v6cl/WinchRack/README.md

WinchRack 
Motor powered standalone spool rewinder for Annex Tradrack

Operates at 5 volt. (Can use 5v pin on control board or external power source)

just 5 voltage, nothing else required.
