v6cl/WinchRack/v0.4/README.md

# WinchRack
Motor powered standalone spool rewinder for Annex Tradrack



Operates at 5 volt. (Can use 5v pin on control board or external power source)

just 5 voltage, nothing else required.

(Example setting)



## Test video

Visit https://www.youtube.com/watch?v=kO5R-0rNxZA

Visit https://www.youtube.com/shorts/trHfZH3sDRs

## BOM

Wago 5pin x 2

Opto endstop x 1 (https://zrr.kr/ZYrV)

n20 gear motor 300 rpm 5v ~ 6v x  1 (https://zrr.kr/aFPa)

ls-p20/15 3kg x 2 (https://zrr.kr/Rqkb)

mosfet switch 1ch x 1 (https://zrr.kr/TrOc)

608zz x 4

623zz x 5

silicon ring x 1 (https://zrr.kr/E5Dk)

PTFE tube 3x4 or 2x4 

m3 insert nut (OD 5mm, L 4mm)

m3 bolts 

m4 bolt 15mm x 2

m2 self tapping screw 8~10mm x 2

6mm collet for 4mm PTFE Tube x 1 (https://zrr.kr/7WdG)

# unresolved problems

- Problem with new filament spools coming loose and tangling

- A state in which the motor rotates infinitely when rewinding after filament is removed from an almost completely used filament spool.
