v6cl/WinchRack/v0.5/STL/Buffer/readme.md

> [!CAUTION]
> For SensorFin, it is recommended to use matte and dark colored filament. Glossy or bright colors produce a weak signal.
