v6cl/WinchRack/v0.6/STL/MotorWheel.stl

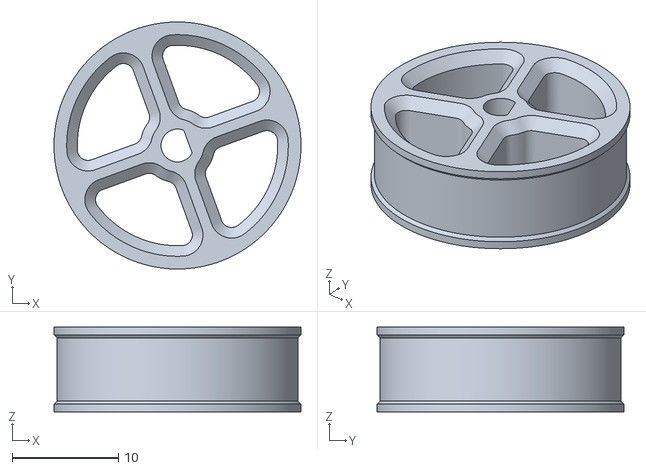
[picture p1: CAD file, 2024-03-28]
v0.6/STL/MotorWheel.stl
23.3 x 23.3 x 8.00
