v6cl/WinchRack/v0.6/STL/HangerExtender.stl

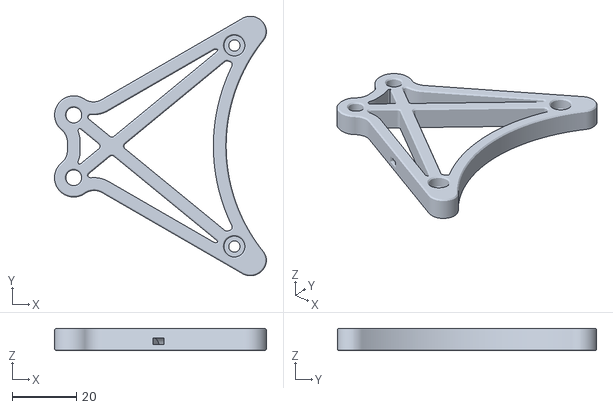
[picture p2: CAD file, 2024-03-28]
v0.6/STL/HangerExtender.stl
66.0 x 80.8 x 7.00
