v6cl/WinchRack/v0.6/STL/SpoolWheel_rev2.stl

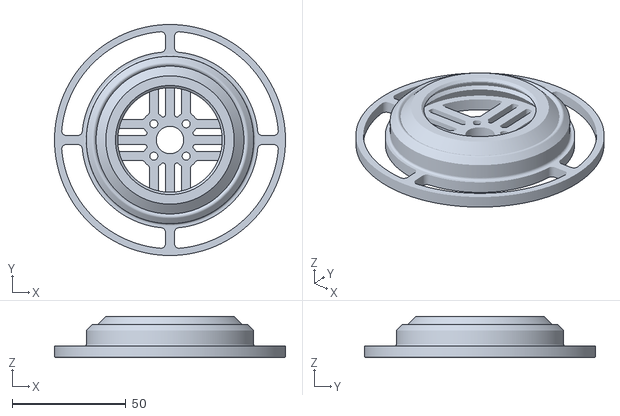
[picture p3: CAD file, 2024-03-28]
v0.6/STL/SpoolWheel_rev2.stl
101.5 x 101.5 x 18.1
