v6cl/WinchRack/v0.6/STL/Wago2411Mount.stl

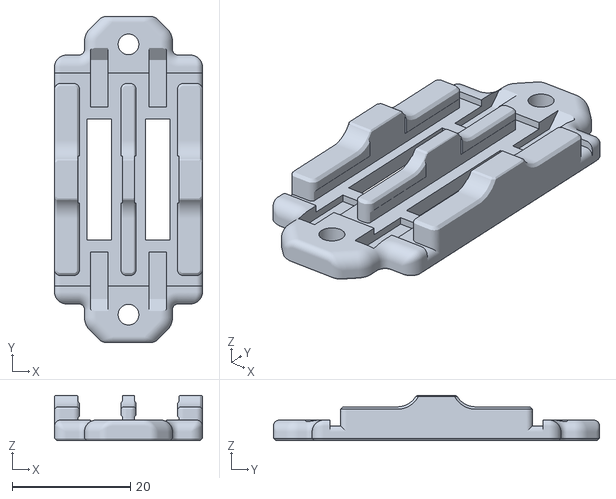
[picture p5: CAD file, 2024-03-28]
v0.6/STL/Wago2411Mount.stl
25.1 x 55.2 x 7.70
