v6cl/WinchRack/v0.6/STL/BufferCore_rev7_b.stl

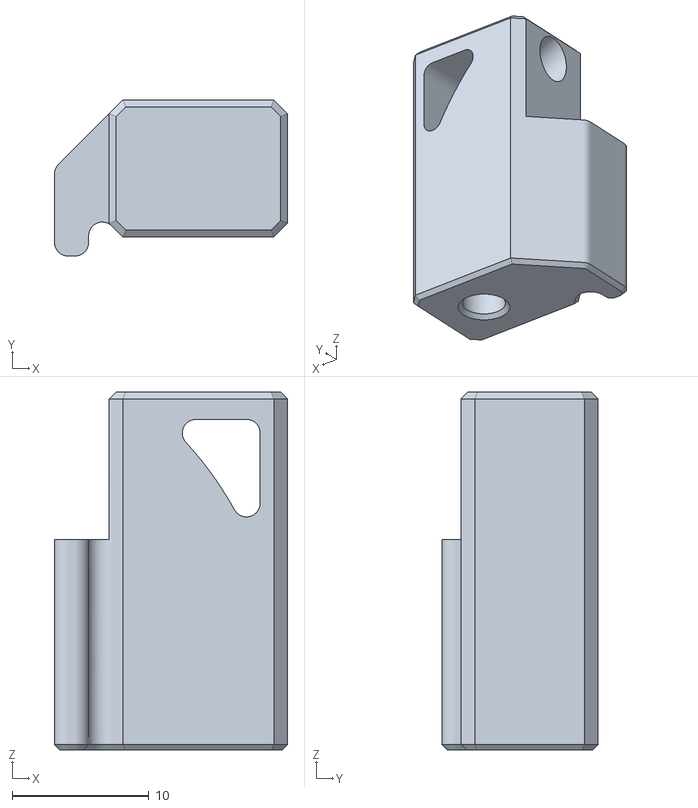
[picture p6: CAD file, 2024-03-28]
v0.6/STL/BufferCore_rev7_b.stl
17.0 x 11.4 x 26.1
