v6cl/WinchRack/v0.6/STL/ProfileFoot.stl

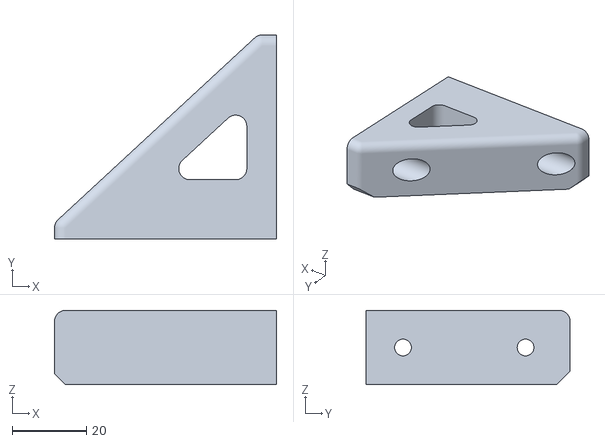
[picture p7: CAD file, 2024-03-28]
v0.6/STL/ProfileFoot.stl
59.8 x 55.0 x 20.0
