v6cl/WinchRack/v0.6/STL/FrontBufferMount_10mmOffset.stl

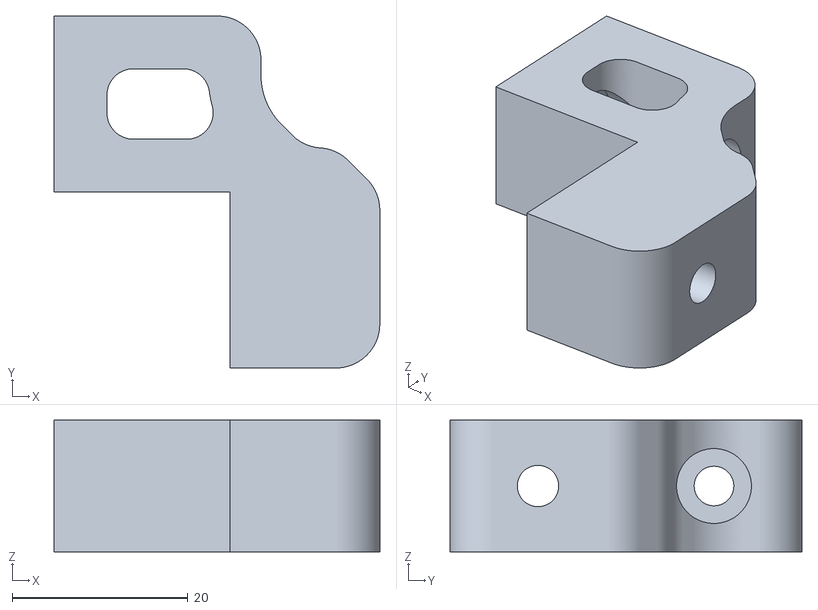
[picture p8: CAD file, 2024-03-28]
v0.6/STL/FrontBufferMount_10mmOffset.stl
37.0 x 40.0 x 15.0
