v6cl/WinchRack/v0.6/STL/RearBufferMount.stl

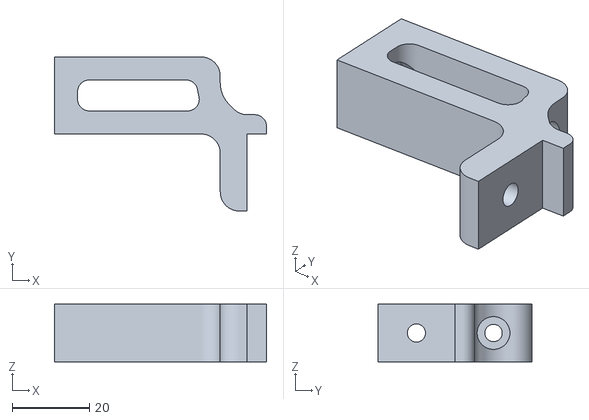
[picture p9: CAD file, 2024-03-28]
v0.6/STL/RearBufferMount.stl
55.0 x 40.0 x 15.0
