v6cl/WinchRack/v0.6/STL/RearBufferMount_10mmOffset.stl

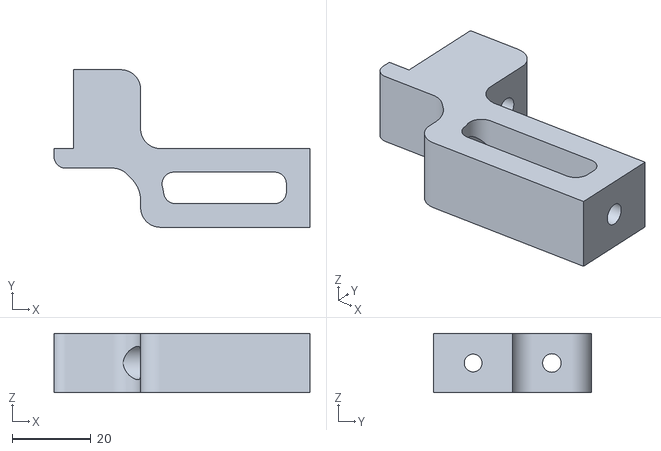
[picture p10: CAD file, 2024-03-28]
v0.6/STL/RearBufferMount_10mmOffset.stl
65.0 x 40.0 x 15.0
