v6cl/WinchRack/v0.6/STL/MotorArm.stl

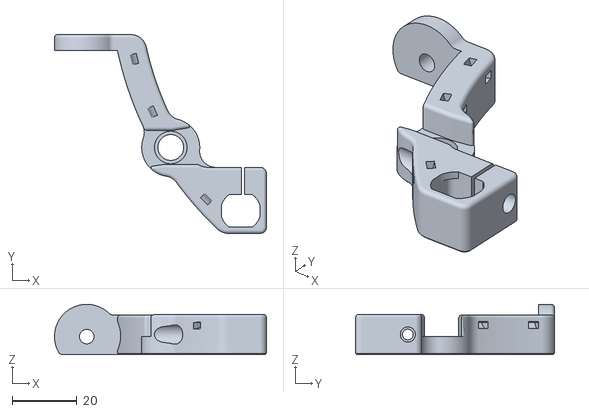
[picture p11: CAD file, 2024-03-28]
v0.6/STL/MotorArm.stl
65.7 x 61.6 x 15.6
