v6cl/WinchRack/v0.6/STL/CornerBrkt.stl

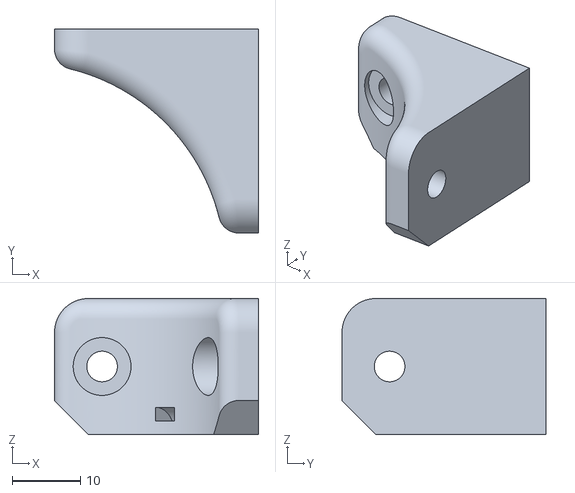
[picture p12: CAD file, 2024-03-28]
v0.6/STL/CornerBrkt.stl
30.0 x 30.0 x 20.0
