v6cl/WinchRack/v0.6/STL/BufferBase_rev4.stl

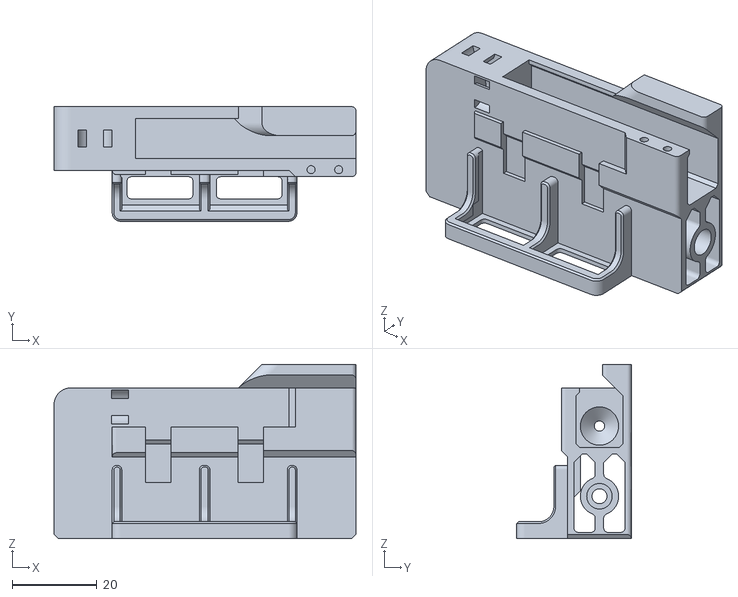
[picture p13: CAD file, 2024-03-27]
v0.6/STL/BufferBase_rev4.stl
71.1 x 27.0 x 41.1
