v6cl/WinchRack/v0.4/STL/Buffer/BufferWheel.stl

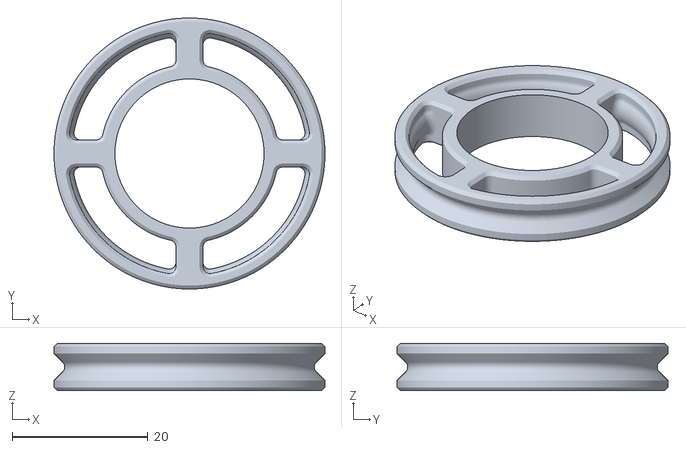
[picture p14: CAD file, 2024-02-13, an earlier design]
v0.4/STL/Buffer/BufferWheel.stl
40.0 x 40.0 x 7.00
