v6cl/WinchRack/v0.4/STL/Spool/SpoolRoller/RollerGripCore.stl

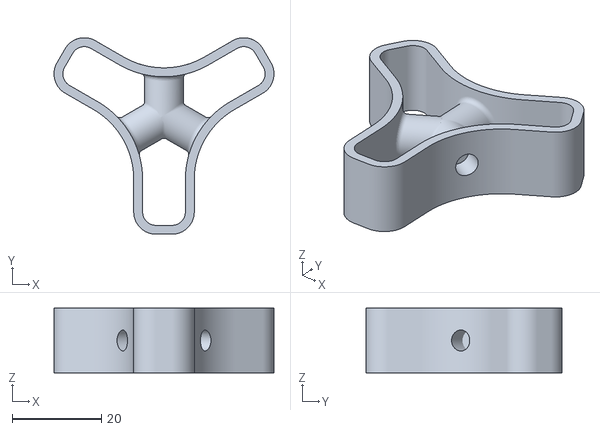
[picture p15: CAD file, 2024-02-13, an earlier design]
v0.4/STL/Spool/SpoolRoller/RollerGripCore.stl
49.4 x 44.1 x 14.5
