v6cl/WinchRack/v0.4/STL/Spool/SpoolStand/StandSidebar.stl

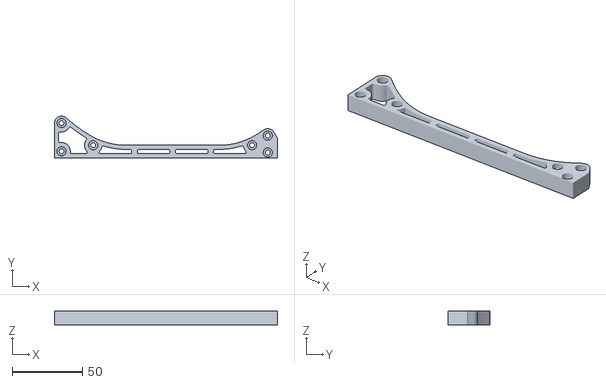
[picture p16: CAD file, 2024-02-13, an earlier design]
v0.4/STL/Spool/SpoolStand/StandSidebar.stl
158.2 x 29.7 x 10.0
