v6cl/WinchRack/v0.5/STL/Buffer/BufferCarrier_rev2.stl

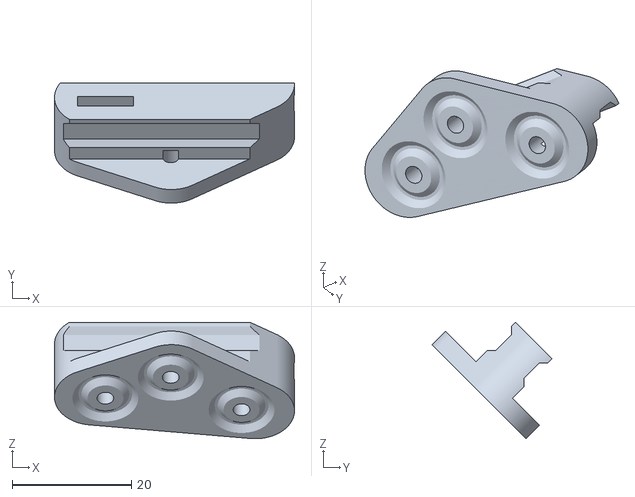
[picture p17: CAD file, 2024-02-27, an earlier design]
v0.5/STL/Buffer/BufferCarrier_rev2.stl
40.2 x 20.1 x 19.5
