v6cl/WinchRack/(list of files, cad)

Other CAD files:
v0.4/STL/Spool/AccelMotor/MotorWheel.stl
v0.4/STL/Buffer/BufferCarrier.stl
v0.4/STL/Buffer/BufferCarrierCover.stl
v0.4/STL/Buffer/BufferConnector.stl
v0.4/STL/Buffer/BufferRail.stl
v0.4/STL/Buffer/SensorFin.stl
v0.4/STL/Buffer/StopBlock.stl
v0.4/STL/Spool/AccelMotor/MagnetBar.stl
v0.4/STL/Spool/AccelMotor/MagnetLever.stl
v0.4/STL/Spool/AccelMotor/MotorCap.stl
v0.4/STL/Spool/SpoolRoller/RollerGrip.stl
v0.4/STL/Spool/SpoolRoller/RollerGrip608Cap_x3.stl
v0.4/STL/Spool/SpoolRoller/SpoolRollerWheel.stl
v0.4/STL/Spool/SpoolRoller/SpoolScrew.stl
v0.4/STL/Spool/SpoolStand/Body.stl
v0.4/STL/Spool/SpoolStand/FrontFoot.stl
v0.4/STL/Spool/SpoolStand/RearFoot.stl
v0.4/STL/Spool/SpoolStand/StableTag.stl
v0.5/STL/Buffer/BufferCarrierCover_Inner_rev2.stl
v0.5/STL/Buffer/BufferCarrierCover_Outer[Option].stl
v0.5/STL/Buffer/BufferConnector_Left.stl
v0.5/STL/Buffer/BufferConnector_Right_rev2.stl
v0.5/STL/Buffer/BufferRail_rev2.stl
v0.5/STL/Buffer/SensorFin_rev2.stl
v0.5/STL/Spool/AccelMotor/MagnetLever.stl
v0.5/STL/Spool/AccelMotor/MagnetMount_rev2.stl
v0.5/STL/Spool/AccelMotor/MotorCap_rev2.stl
v0.5/STL/Spool/AccelMotor/MotorWheel.stl
v0.5/STL/Spool/SpoolRoller/RollerGrip.stl
v0.5/STL/Spool/SpoolRoller/RollerGrip608Cap_x3.stl
v0.5/STL/Spool/SpoolRoller/SpoolRollerWheel.stl
v0.5/STL/Spool/SpoolRoller/SpoolScrew.stl
v0.5/STL/Spool/SpoolStand/FrontBar.stl
v0.5/STL/Spool/SpoolStand/StandBody.stl
v0.5/STL/Spool/SpoolStand/StandSidebar.stl
