v6cl/WinchRack/v0.5/Doc/WinchRack V0.5 Assemble.pdf

# Assemble Stand body

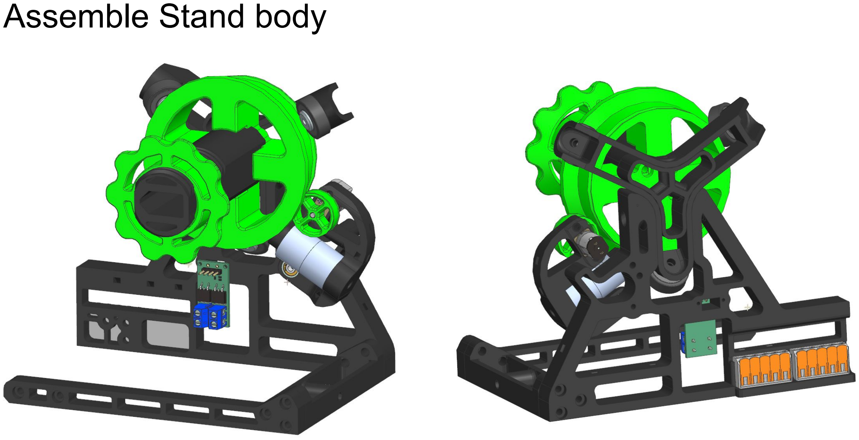
[picture p18: page 1]

# Assemble Stand body

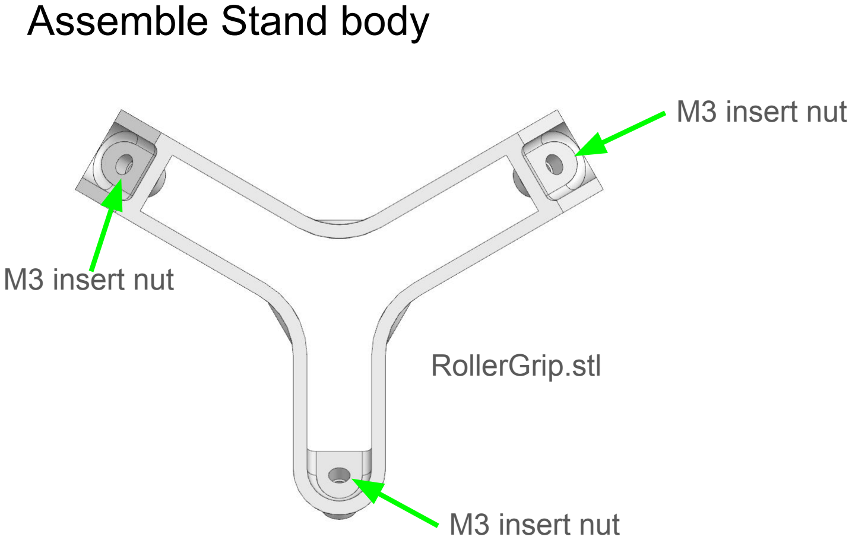
[picture p19: page 2]

## RollerGrip.stl

## M3 insert nut

## M3 insert nut

## M3 insert nut

# Assemble Stand body

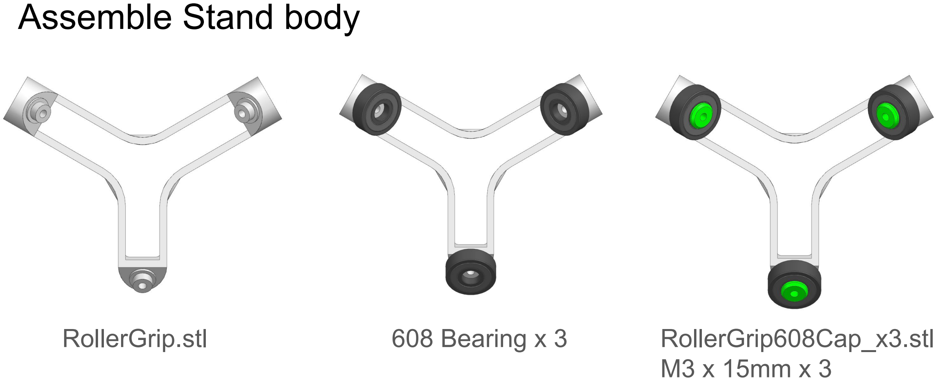
[picture p20: page 3]

RollerGrip.stl | 608 Bearing x 3 | RollerGrip608Cap_x3.stl M3 x 15mm x 3

# Assemble Stand body

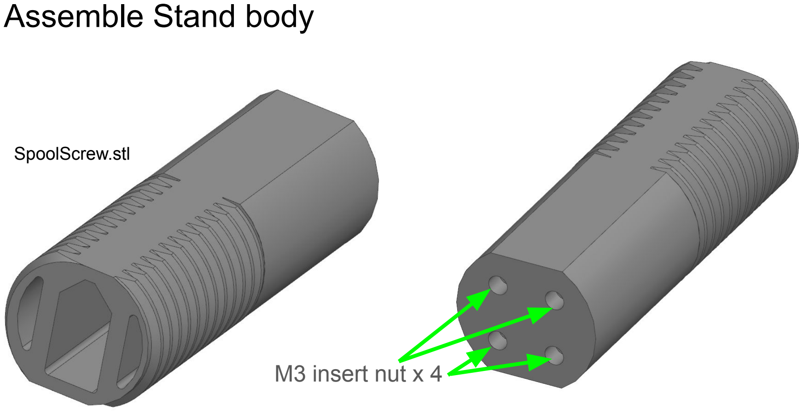
[picture p21: page 4]

## M3 insert nut x 4

SpoolScrew.stl

# Assemble Stand body

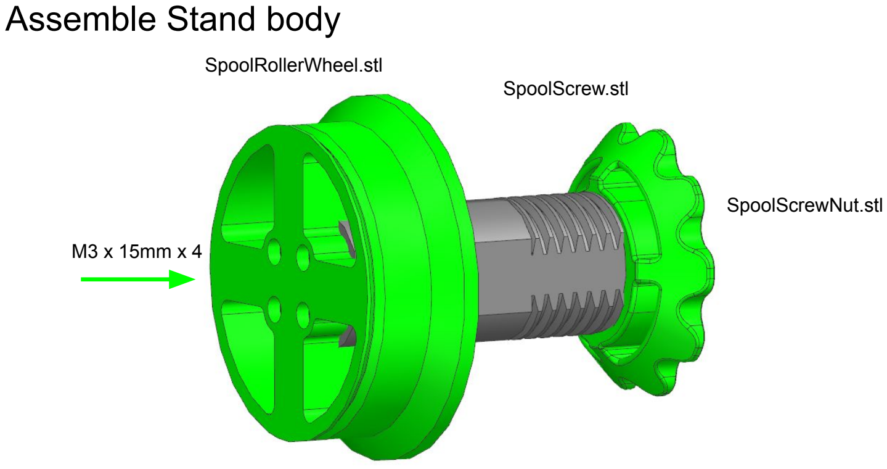
[picture p22: page 5]

SpoolScrew.stl

SpoolRollerWheel.stl

SpoolScrewNut.stl

M3 x 15mm x 4

# Assemble Stand body

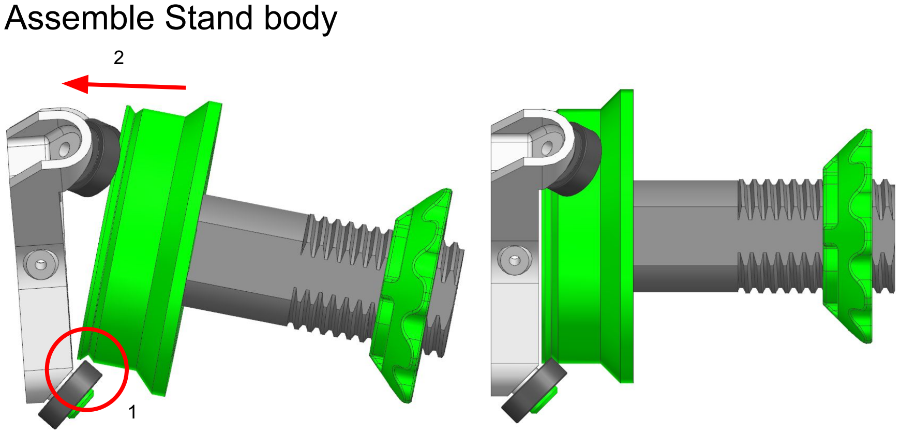
[picture p23: page 6]

1

2

# Assemble Stand body M3 insert nut

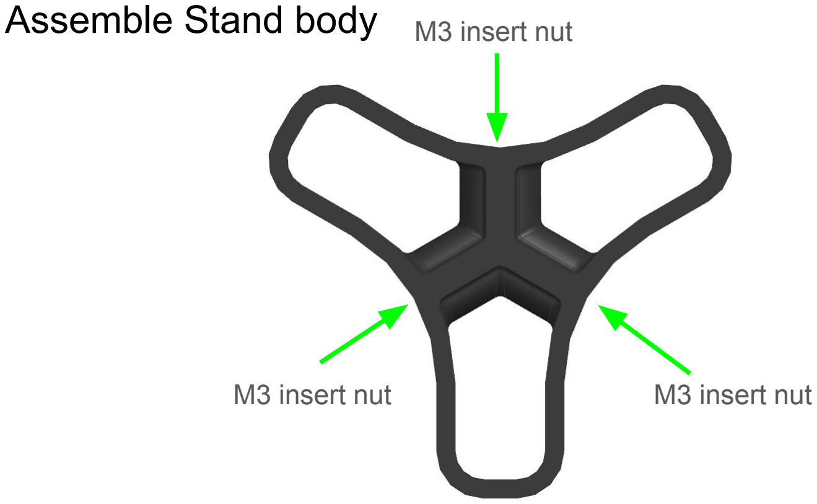
[picture p24: page 7]

M3 insert nut | M3 insert nut

# Assemble Stand body

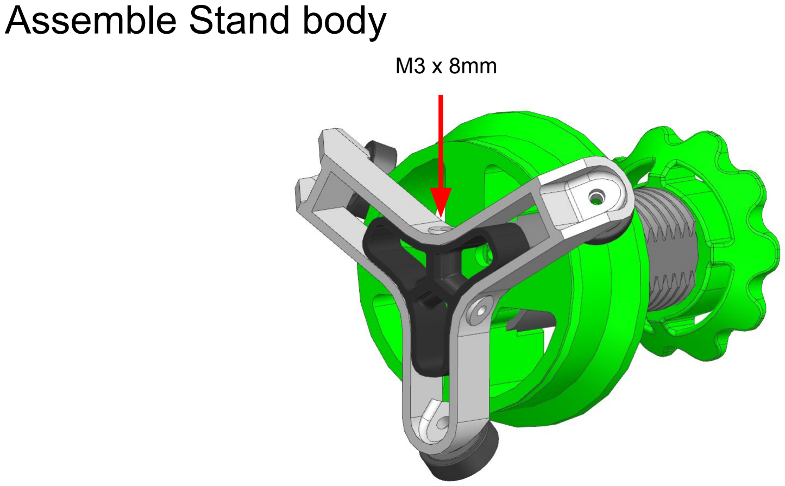
[picture p25: page 8]

M3 x 8mm

# Assemble Stand body

## M3 insert nut x 2

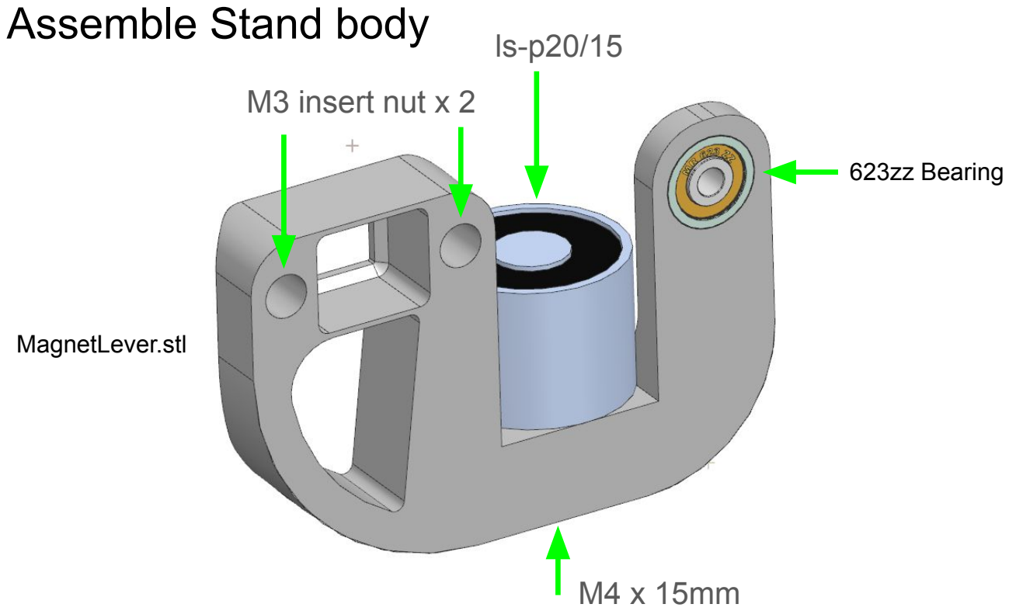
[picture p26: page 9]

MagnetLever.stl

623zz Bearing

## ls-p20/15

## M4 x 15mm

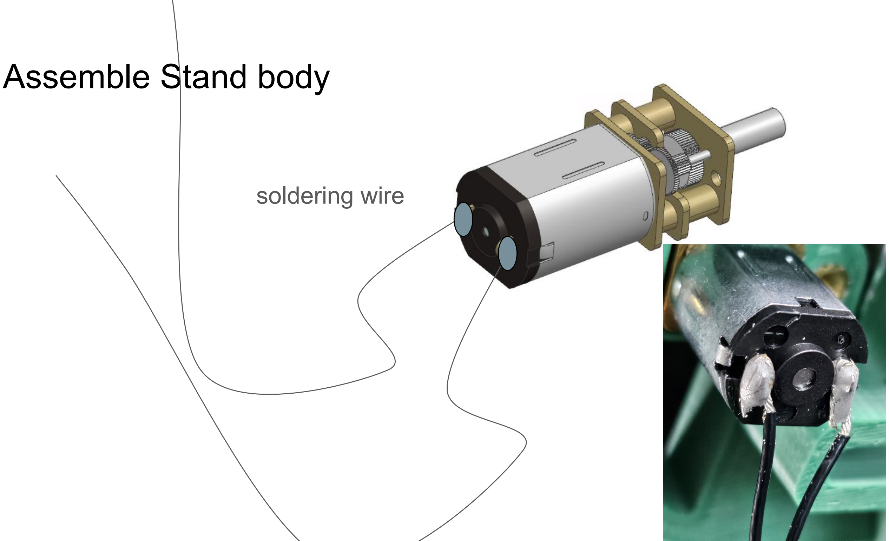
[picture p27: figure]
Assemble Stand body; soldering wire

# Assemble Stand body

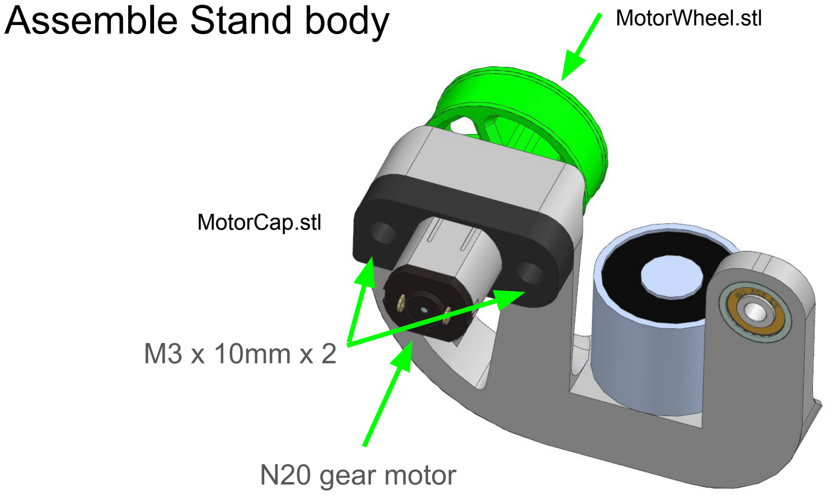
[picture p28: page 11]

## N20 gear motor

## M3 x 10mm x 2

MotorCap.stl

MotorWheel.stl

# Assemble Stand body

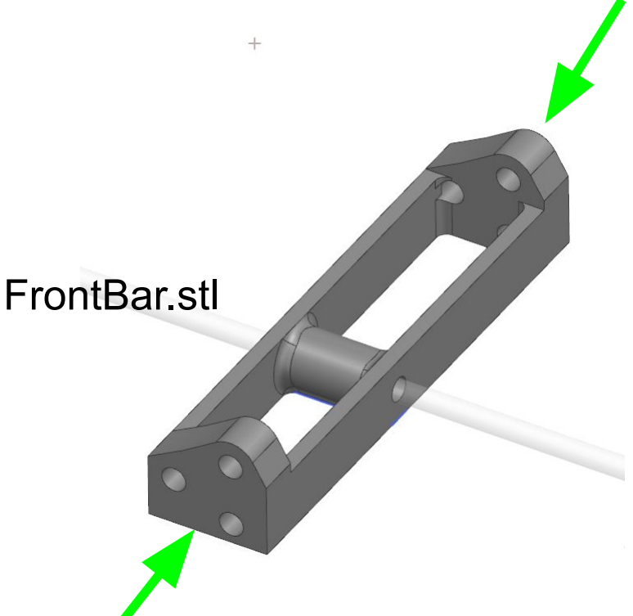
[picture p29: figure]
FrontBar.stl

## M3 insert nut x 3

## M3 insert nut x 3

# Assemble Stand body

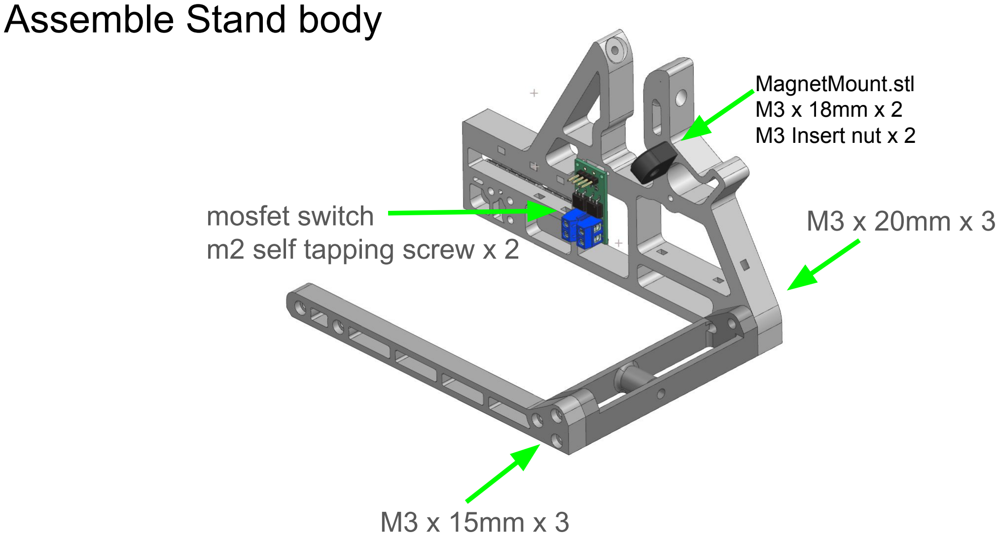
[picture p30: page 13]

## M3 x 15mm x 3

## mosfet switch m2 self tapping screw x 2

## M3 x 20mm x 3

MagnetMount.stl
M3 x 18mm x 2
M3 Insert nut x 2

# Assemble Stand body

## ls-p20/15

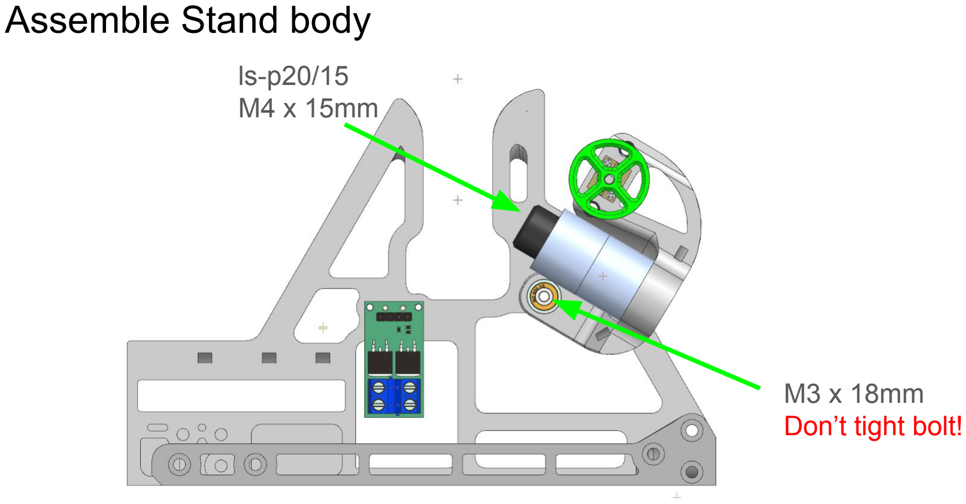
[picture p31: page 14]

## M4 x 15mm

## M3 x 18mm Don’t tight bolt!

# Assemble Stand body

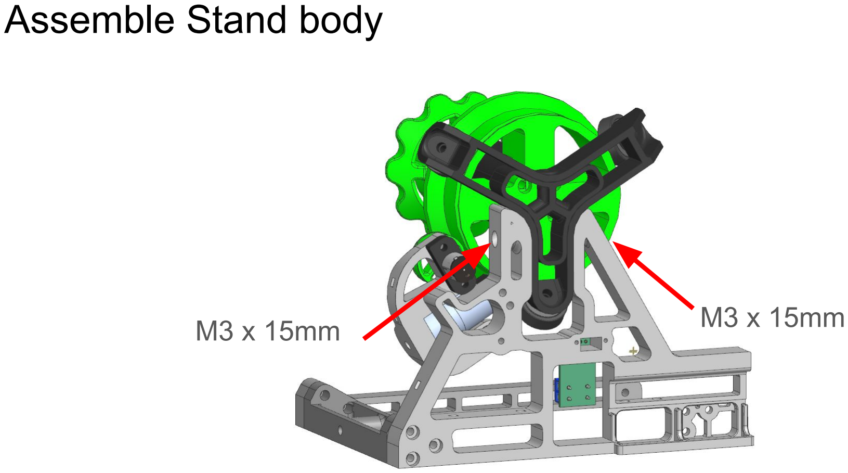
[picture p32: page 15]

M3 x 15mm | M3 x 15mm

# Assemble Buffer Module

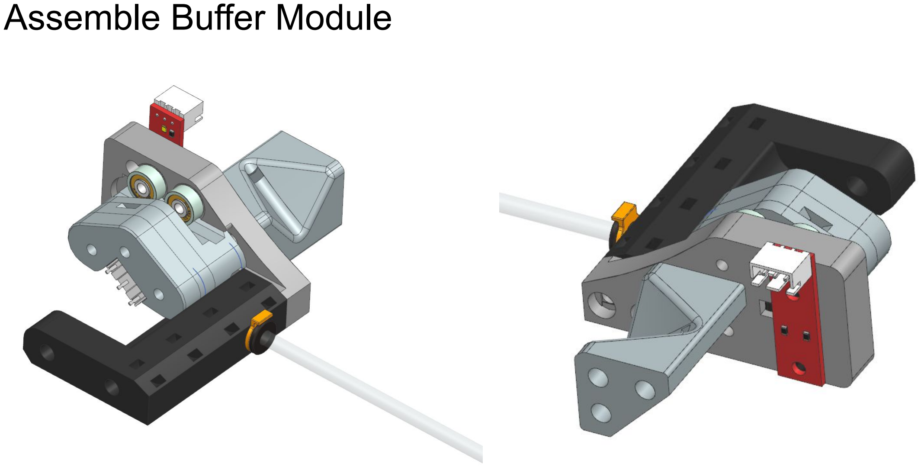
[picture p33: page 16]

# Assemble

## 623 Bearing x4

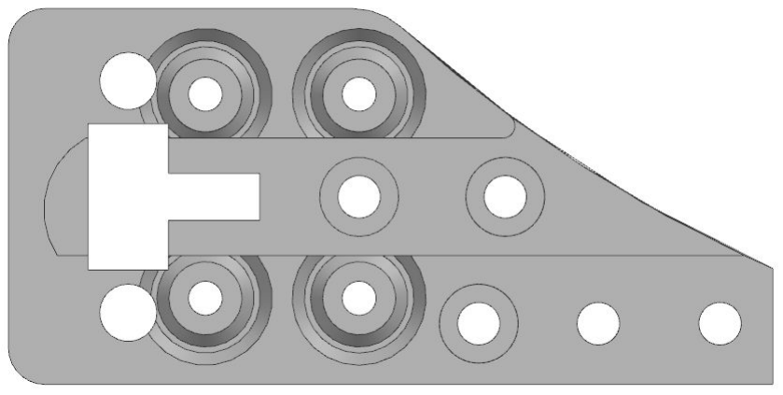
[picture p34: figure]
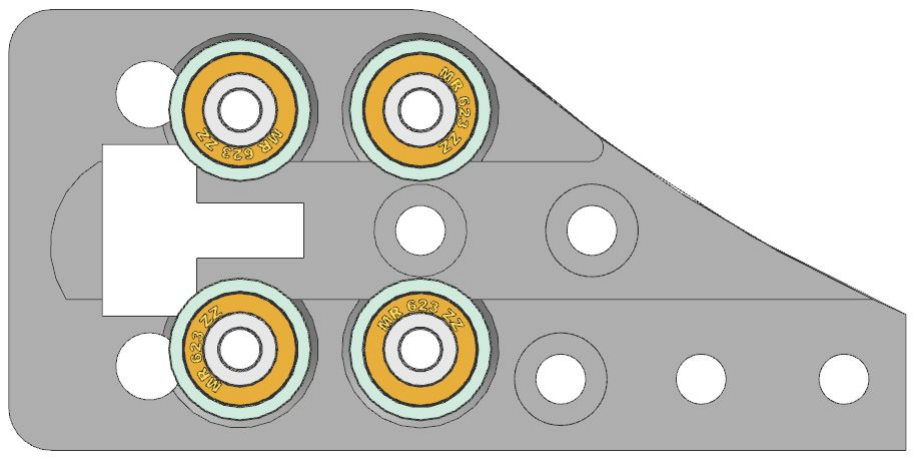
[picture p35: figure]

BufferRail.stl | M3 x 12mm x 4

# Assemble

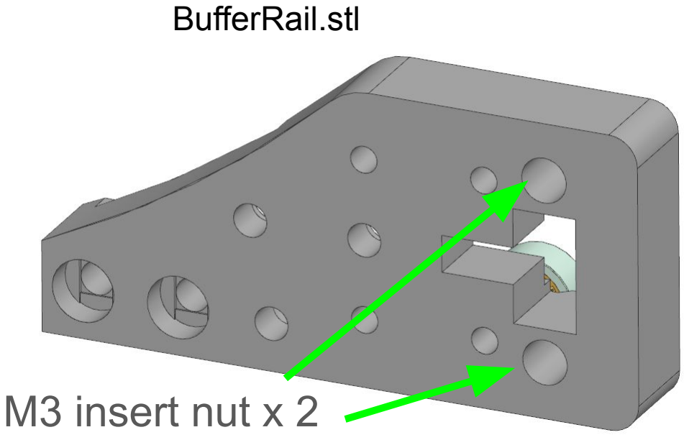
[picture p36: figure]
BufferRail.stl; M3 insert nut x 2

# Assemble

## M3 insert nut x 3

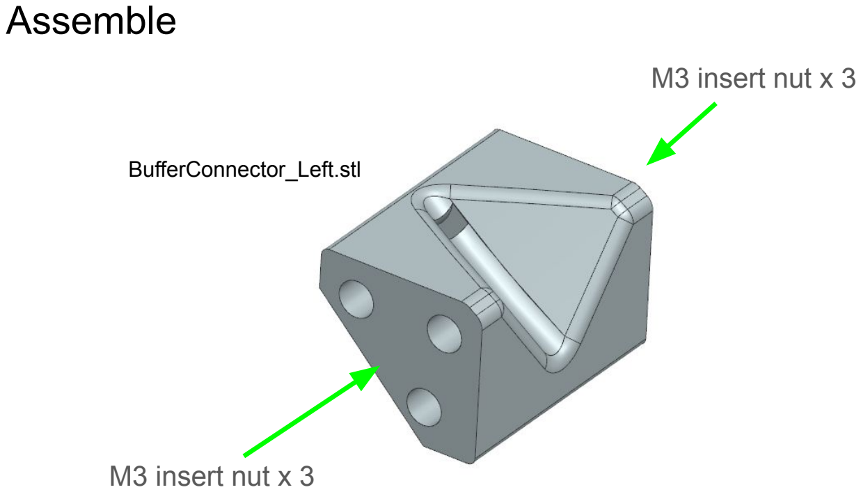
[picture p37: page 19]

## M3 insert nut x 3

BufferConnector_Left.stl

# Assemble

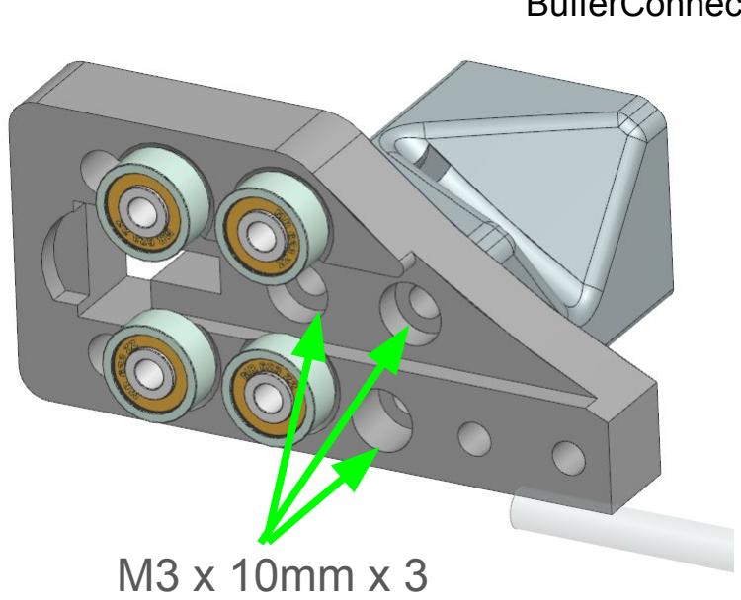
[picture p38: figure]

BufferConnector_Left.stl

BufferRail.stl

# Assemble

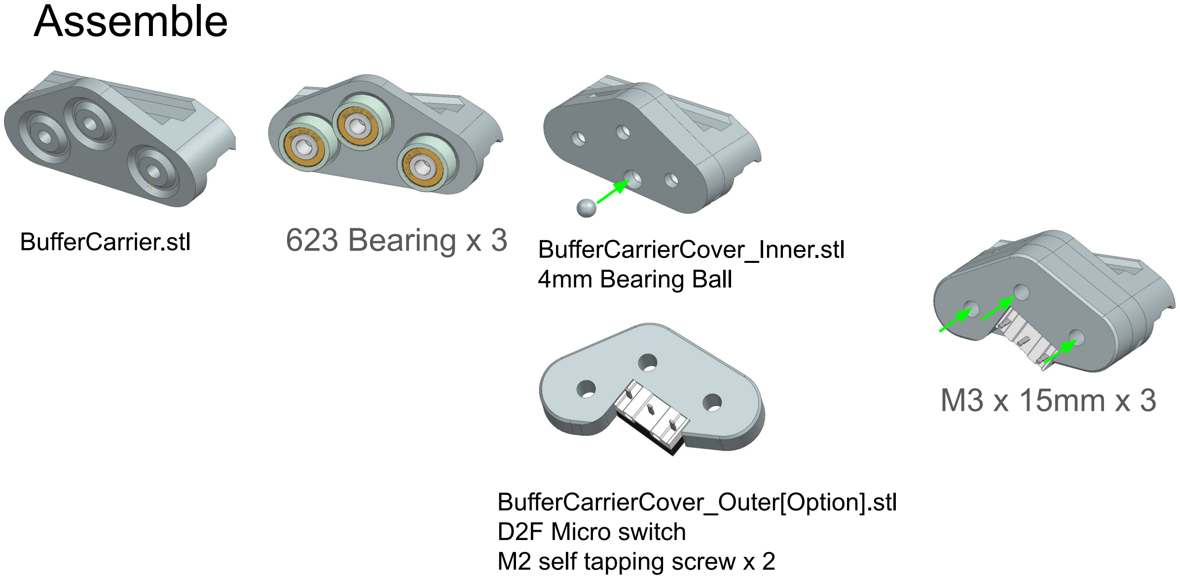
[picture p39: page 21]

BufferCarrierCover_Inner.stl 4mm Bearing Ball

BufferCarrier.stl | 623 Bearing x 3

BufferCarrierCover_Outer[Option].stl D2F Micro switch
M2 self tapping screw x 2

## M3 x 15mm x 3

# Assemble

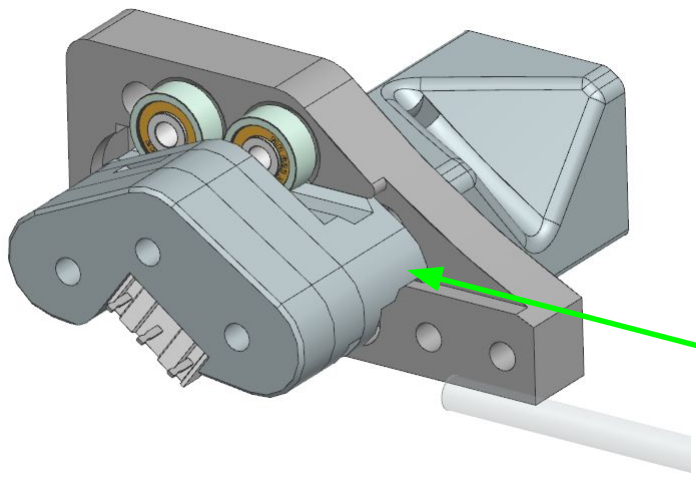
[picture p40: figure]

# Assemble

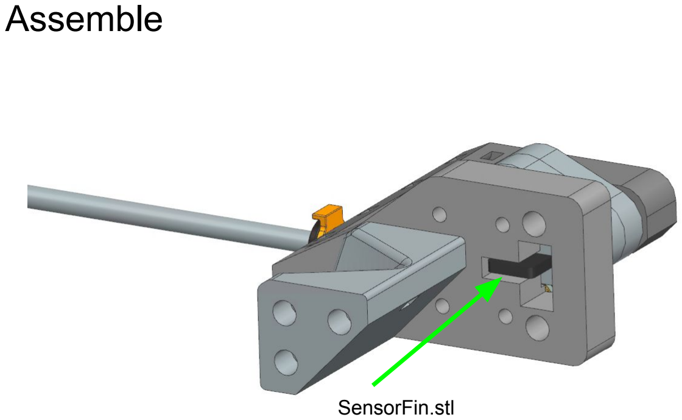
[picture p41: page 23]

SensorFin.stl

# Assemble

## M3 Insert nut x2

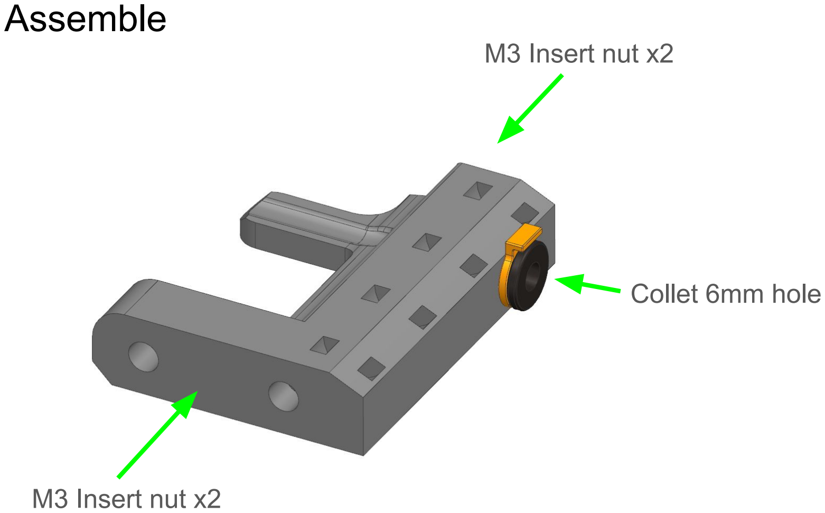
[picture p42: page 24]

## Collet 6mm hole

## M3 Insert nut x2

# Assemble

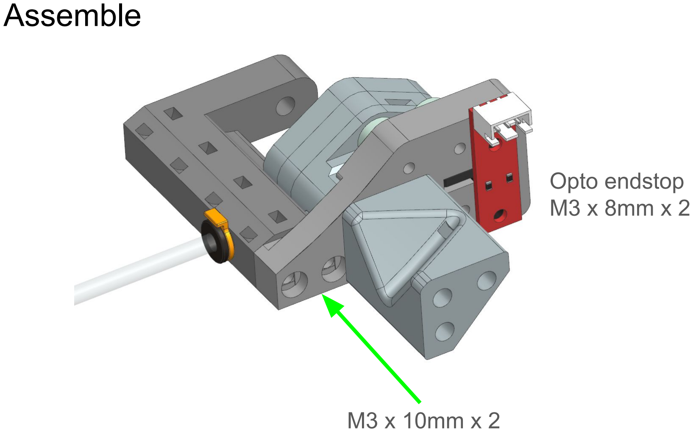
[picture p43: page 25]

## M3 x 10mm x 2

## Opto endstop M3 x 8mm x 2

# Assemble

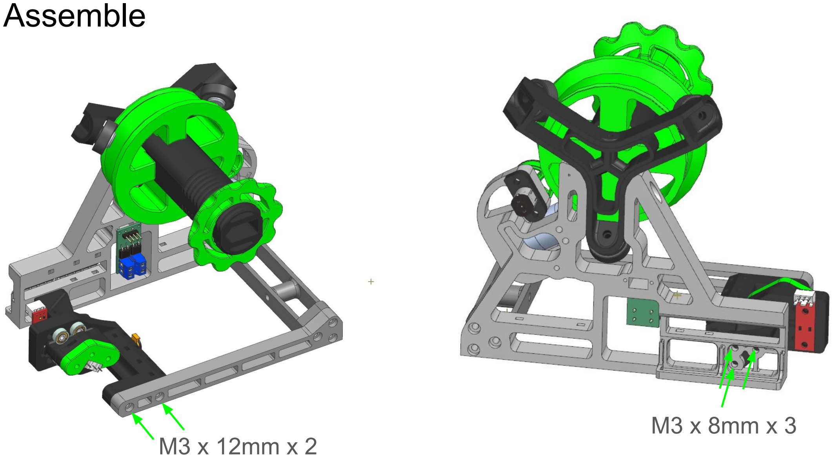
[picture p44: page 26]

## M3 x 12mm x 2

## M3 x 8mm x 3

# Assemble

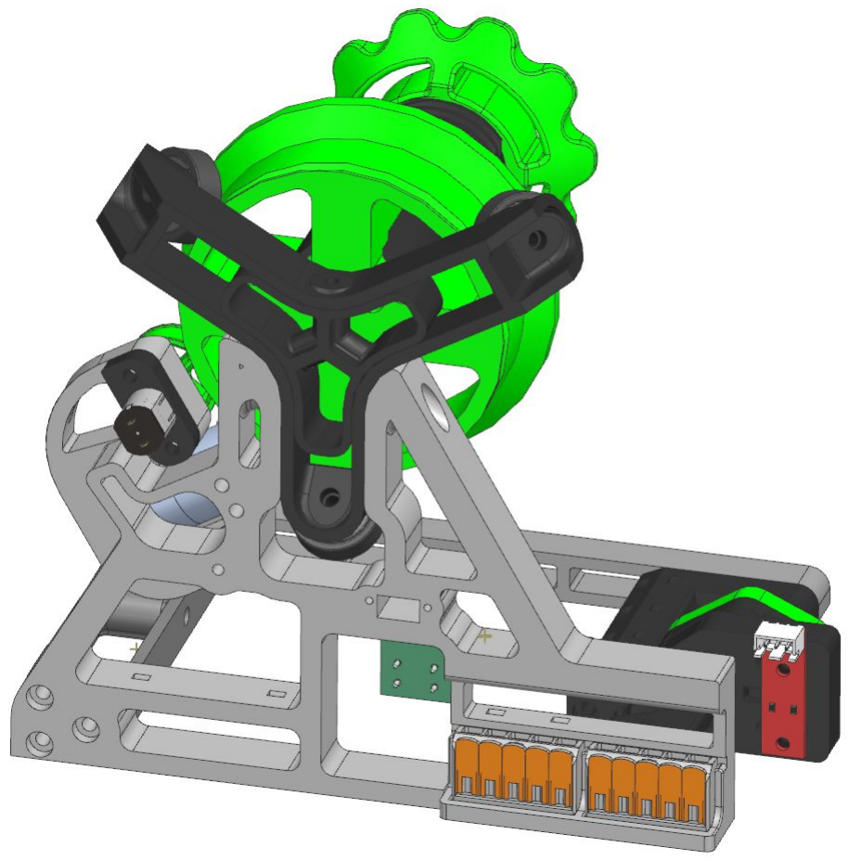
[picture p45: figure]

## Wago 5 pin x 2

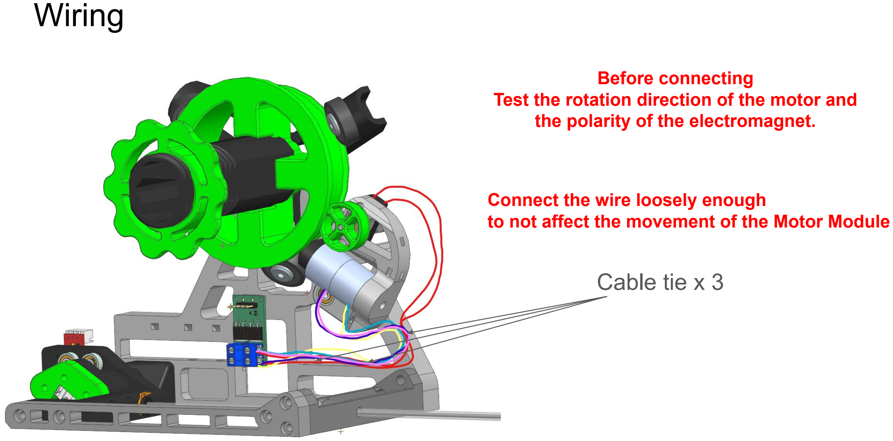
[picture p46: figure]
Wiring; Before connecting; the polarity of the electromagnet.; Cable tie x 3; Connect the wire loosely enough

Test the rotation direction of the motor and

to not affect the movement of the Motor Module

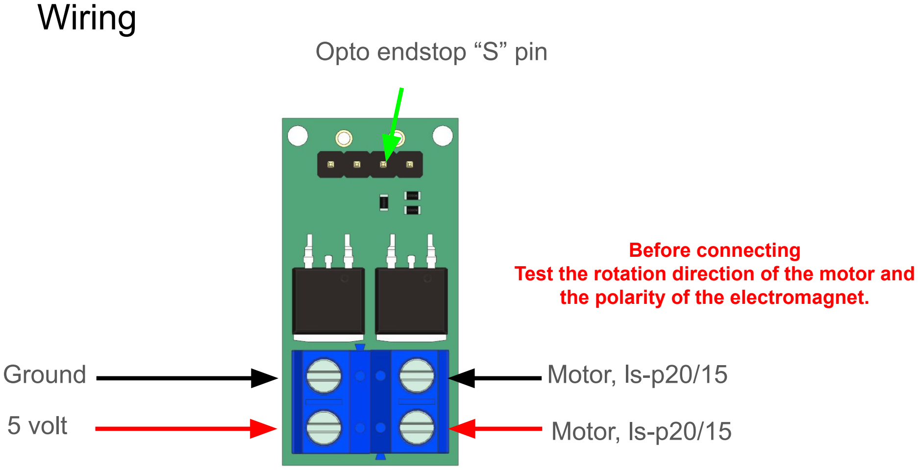
[picture p47: figure]
Wiring; Opto endstop “S” pin; Ground; 5 volt; Motor, ls-p20/15; Before connecting; the polarity of the electromagnet.

Test the rotation direction of the motor and

# Wiring

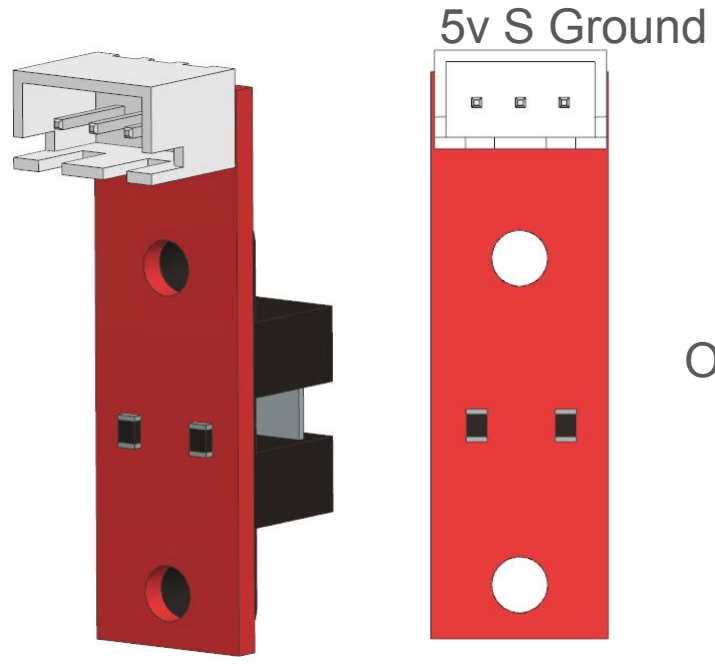
[picture p48: figure]
5v S Ground

## Opto endstop

# Wiring

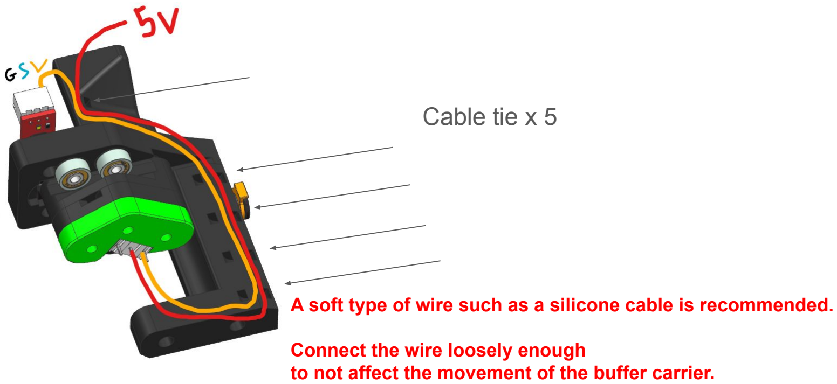
[picture p49: figure]
Connect the wire loosely enough; Cable tie x 5

A soft type of wire such as a silicone cable is recommended.

to not affect the movement of the buffer carrier.

# Wiring

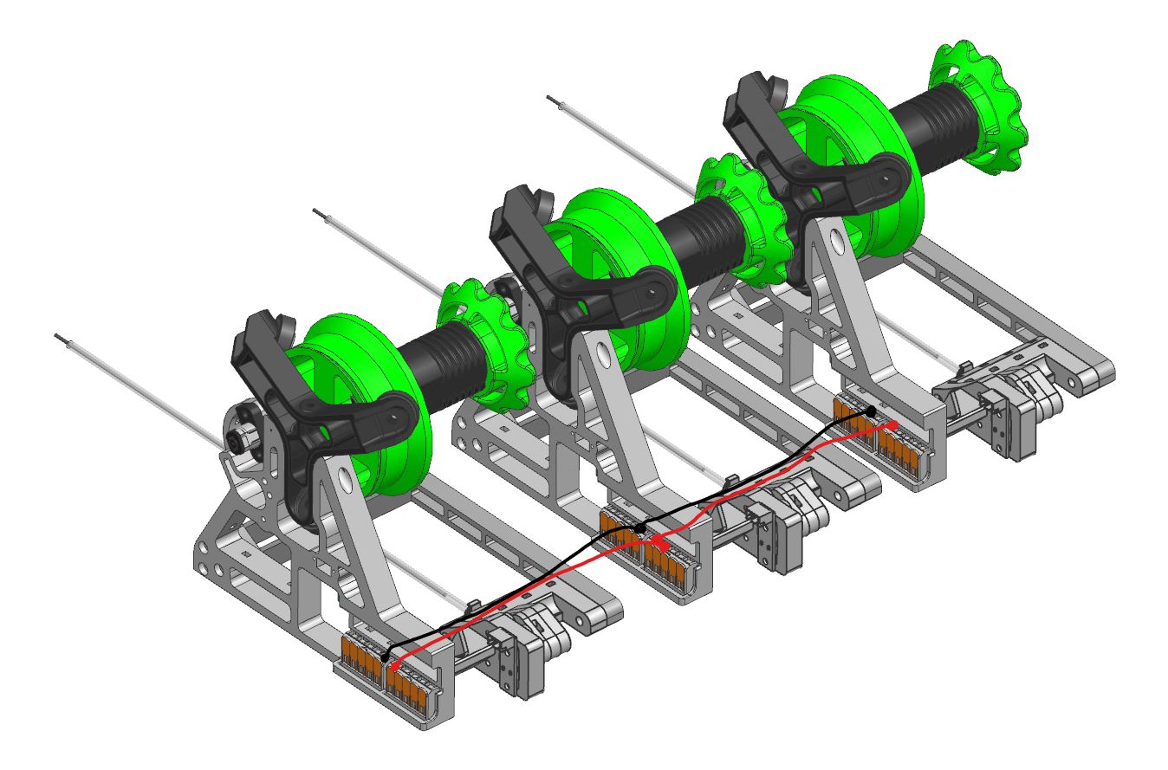
[picture p50: figure]
