v6cl/WinchRack/(commit log)

2024-02-13 File upload
    [Body.stl, BufferCarrier.stl, BufferCarrierCover.stl, BufferConnector.stl, BufferRail.stl, BufferWheel.stl, FrontFoot.stl, MagnetBar.stl]
2024-02-17 v0.5 Update
    [Body.stl, BufferCarrier.stl, BufferCarrierCover.stl, BufferCarrierCover_Inner.stl, BufferCarrierCover_Outer[Option].stl, BufferConnector.stl, BufferConnector_Left.stl, BufferConnector_Right.stl]
2024-02-17 Create WinchRack V0.5 Assemble.pdf
2024-02-18 Update WinchRack V0.5 Assemble.pdf
    fix bolt length
2024-02-18 Update WinchRack V0.5 Assemble.pdf
2024-02-22 Some gap fix
    [MagnetMount.stl, MagnetMount_rev2.stl, MotorCap.stl, MotorCap_rev2.stl]
2024-02-25 shorter fin
    [SensorFin.stl, SensorFin_rev2.stl]
2024-02-26 BufferRail_rev2.stl update
    reduce "selector_unload_length_extra"
    [BufferRail.stl, BufferRail_rev2.stl]
2024-02-27 stl file fix
    [BufferCarrier.stl, BufferCarrierCover_Inner.stl, BufferCarrierCover_Inner_rev2.stl, BufferCarrier_rev2.stl, BufferConnector_Right.stl, BufferConnector_Right_rev2.stl]
2024-03-01 Update README.md
    There is an Ali store that sells used n20 motors, so I changed the link to another store.
2024-03-27 10mm offset Mount
    [FrontBufferMount_10mmOffset.stl, RearBufferMount_10mmOffset.stl]
2024-03-28 Place on face stl files
    [BufferBase.stl, BufferBase_rev4.stl, BufferCore.stl, BufferCore_rev7_b.stl, CornerBrkt.stl, FrontBufferMount.stl, FrontBufferMount_10mmOffset.stl, HangerExtender.stl]
